kyuditsky/rPi_hat/5013-5v/LM5013-Q1_PSPICE_TRANS/LM5013-Q1_PSPICETransientModel_FeaturesandLimitations.pdf

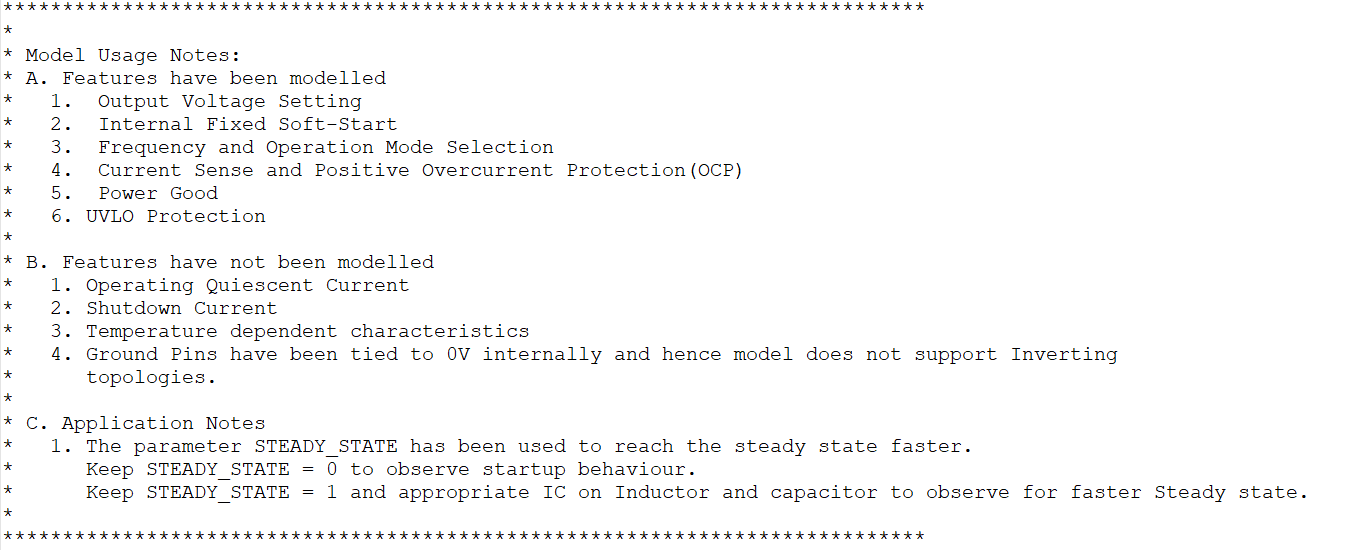
[picture p1: figure]
