kyuditsky/rPi_hat/5013-5v/5013-5v/lm5013_5v.png

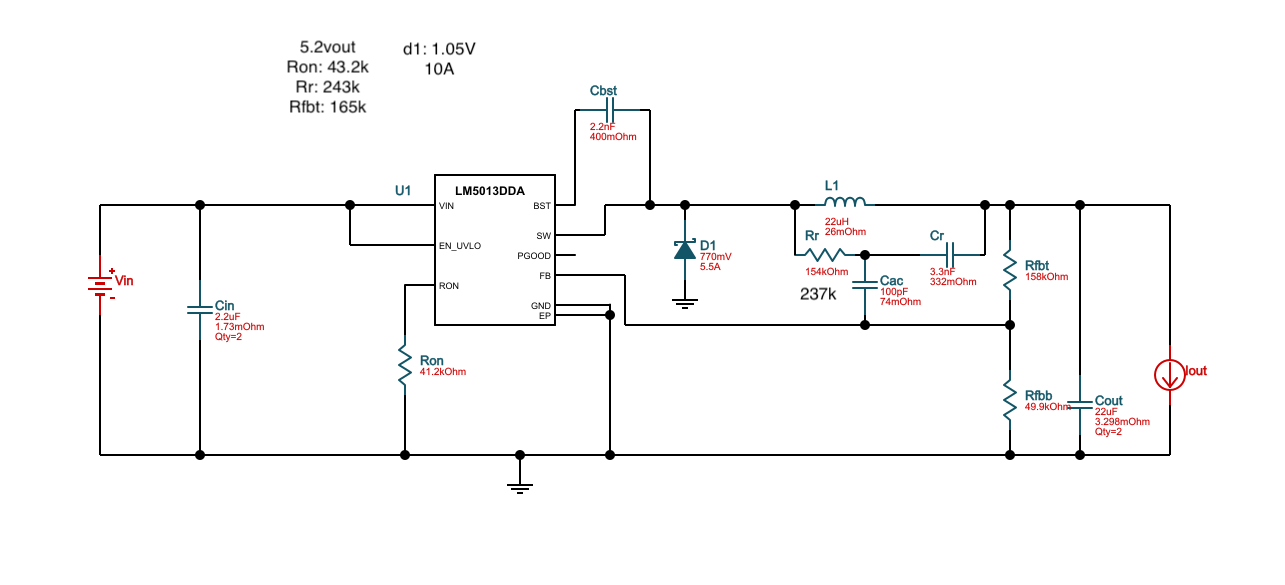
5013-5v/5013-5v/lm5013_5v.png
