kyuditsky/rPi_hat/(list of files, drawings)

Other design files:
5013-5v/LM5013-Q1_PSPICE_TRANS/LM5013-Q1_TRANS.OPJ
5013-5v/LM5013-Q1_PSPICE_TRANS/LM5013-Q1DDA_TRANS.OLB
