kyuditsky/rPi_hat/5013-5v/5013-5v/5013-5v.kicad_pcb

## KiCad design 5013-5v/5013-5v/5013-5v.kicad_pcb (2026-02-10)

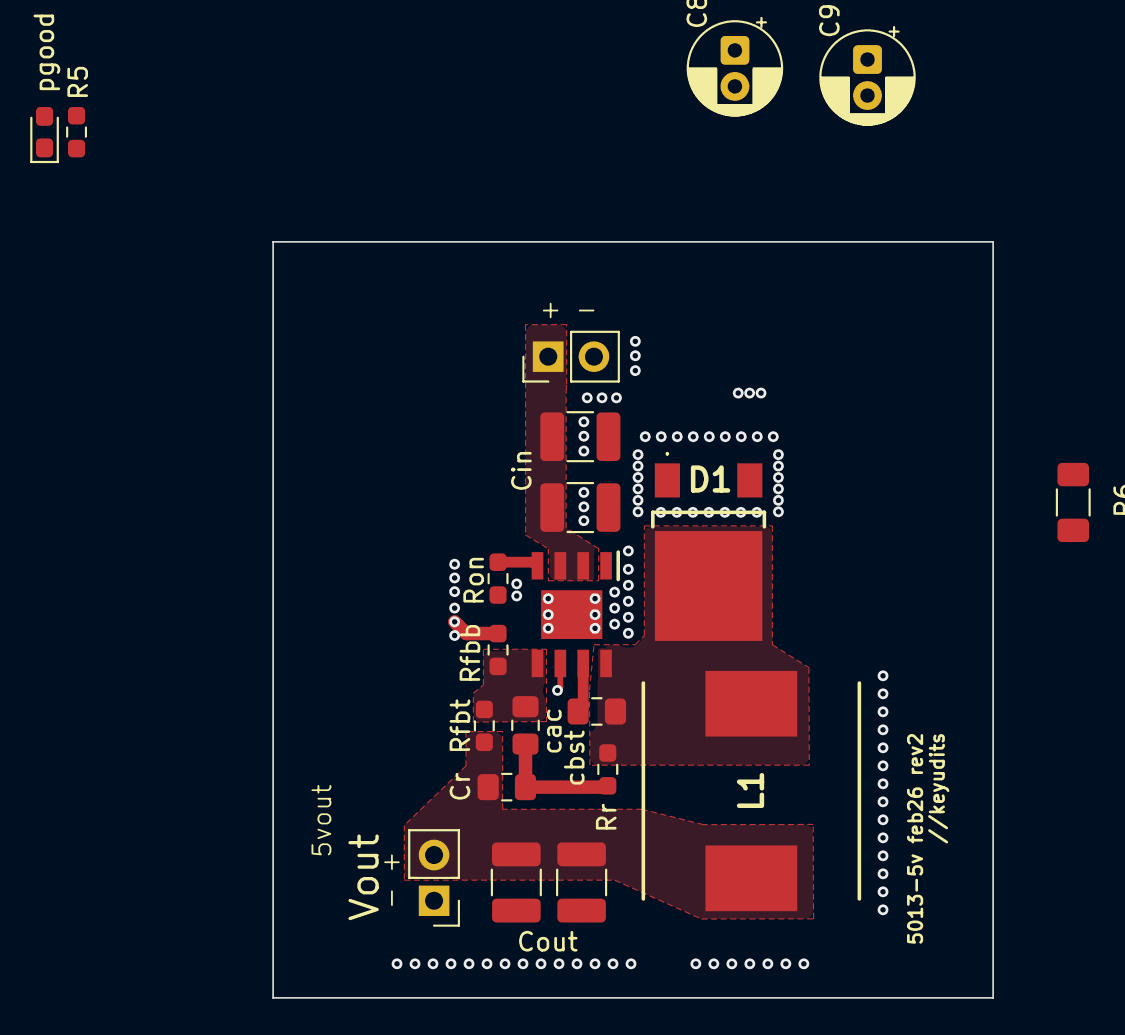
[picture p3: board 5013-5v.kicad_pcb from above]

Board: 2 copper layers, 40.0 x 42.0 mm, 21 parts (0 on the bottom side), 11 nets.

Parts:
C8, C9: C_Polarized; CP_Radial_D5.0mm_P2.00mm
Cin: 2.2u; C_1210_3225Metric_Pad1.33x2.70mm_HandSolder
Cin#2: 2.2uF; C_1210_3225Metric_Pad1.33x2.70mm_HandSolder
Cout: 22uF; C_1210_3225Metric_Pad1.33x2.70mm_HandSolder
Cout#2: 22uF; C_1210_3225Metric_Pad1.33x2.70mm_HandSolder
Cr: 3.3nF; C_0805_2012Metric_Pad1.18x1.45mm_HandSolder
D1: D_Schottky; TO-252-Ae-3
IC1: LM5013DDAR; SOIC127P600X170-9N
L1: 22uH; INDPM120120X1020N
R5: 2.2k; R_0603_1608Metric_Pad0.98x0.95mm_HandSolder
R6: 0; R_1206_3216Metric_Pad1.30x1.75mm_HandSolder
Rfbb: 49.9kOhm; R_0603_1608Metric_Pad0.98x0.95mm_HandSolder
Rfbt: 158kOhm; R_0603_1608Metric_Pad0.98x0.95mm_HandSolder
Ron: 41.2kOhm; R_0603_1608Metric_Pad0.98x0.95mm_HandSolder
Rr: 154kOhm; R_0603_1608Metric_Pad0.98x0.95mm_HandSolder
Vin: Conn_01x02_Pin; PinHeader_1x02_P2.54mm_Vertical
Vout: Conn_01x02_Pin; PinHeader_1x02_P2.54mm_Vertical
cac: 100pF; C_0805_2012Metric_Pad1.18x1.45mm_HandSolder
cbst: 2.2nF 50v X7R; C_0805_2012Metric_Pad1.18x1.45mm_HandSolder
pgood: LED; LED_0603_1608Metric_Pad1.05x0.95mm_HandSolder

Connections:
/Vin: C8.1, C9.1, Cin.1, Cin#2.1, IC1.2 (VIN), IC1.3 (EN/UVLO), Vin.1
/Vout: Cout.1, Cout#2.1, Cr.2, L1.2, Rfbt.1, Vout.2
/fb: IC1.5 (FB), Rfbb.1, Rfbt.2, cac.2
/sw: D1.1 (K), IC1.8 (SW), L1.1, Rr.1, cbst.1
GND: Cout.2, Cout#2.2, R6.1, Rfbb.2, Vout.1, pgood.1 (K)
GND1: C8.2, C9.2, Cin.2, Cin#2.2, D1.2 (A), IC1.1 (GND), IC1.9 (EP), R6.2, Ron.2, Vin.2
unnamed: Cr.1, Rr.2, cac.1
unnamed: IC1.7 (BST), cbst.2
unnamed: IC1.6 (PGOOD), R5.2
unnamed: IC1.4 (RON), Ron.1
unnamed: R5.1, pgood.2 (A)
