kyuditsky/rPi_hat/5013-5v/5013_hat/5013-5V_hat.kicad_pcb

## KiCad design 5013-5v/5013_hat/5013-5V_hat.kicad_pcb (2025-11-10)

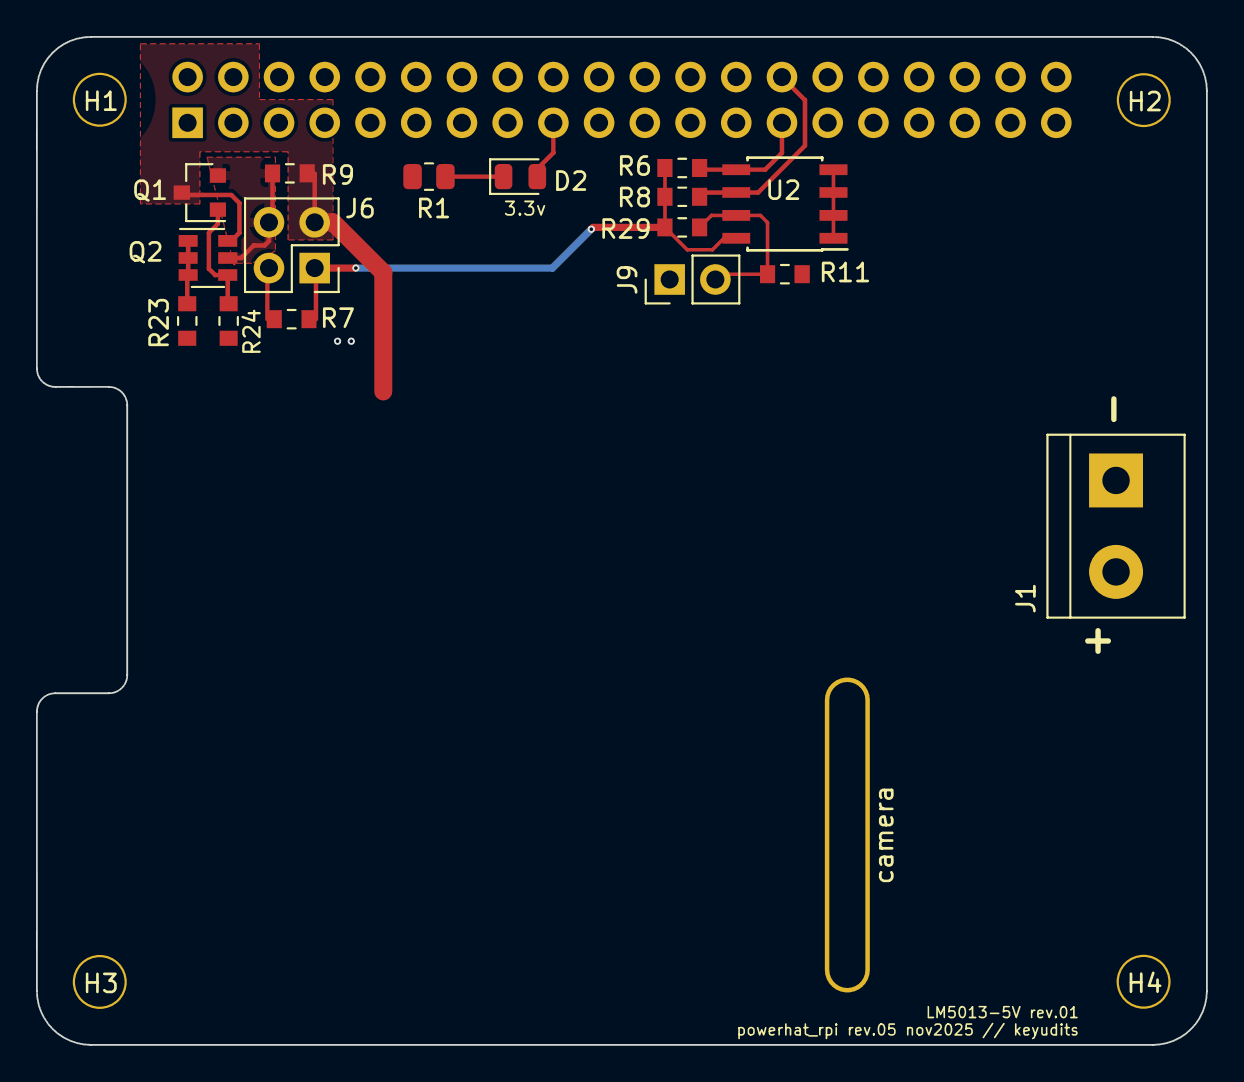
[picture p4: board 5013-5V_hat.kicad_pcb from above]

Board: 2 copper layers, 65.0 x 56.0 mm, 22 parts (1 on the bottom side), 12 nets.

Parts:
D2: LED; LED_0805_2012Metric
H1, H2, H3, H4: 3mm_Mounting_Hole; NPTH_3mm_ID
J1: Input; TerminalBlock_bornier-2_P5.08mm
J3: 40HAT; PinSocket_2x20_P2.54mm_Vertical
J6: CONN_02X02; PinHeader_2x02_P2.54mm_Vertical
J9: CONN_01X02; PinHeader_1x02_P2.54mm_Vertical
Q1: DMG2305UX; SOT-23
Q2: DMMT5401; SOT-23-6
R1: 2.2k; R_0805_2012Metric
R6, R8: 3.9K; R_0603_1608Metric_Pad0.84x1.00mm_HandSolder
R7, R9, R11: DNP; R_0603_1608Metric_Pad0.84x1.00mm_HandSolder
R23, R29: 10K; R_0603_1608Metric_Pad0.84x1.00mm_HandSolder
R24: 47K; R_0603_1608Metric_Pad0.84x1.00mm_HandSolder
U2: CAT24C32; SOIC-8_3.9x4.9mm_P1.27mm
camera: raspberry_pi_camera_cutout

Connections:
/ID_SC_EEPROM: J3.28 (BCM1), R8.2, U2.6 (SCL)
/ID_SD_EEPROM: J3.27 (BCM0), R6.2, U2.5 (SDA)
/LED: D2.2 (A), J3.17 (P3V3)
/P3V3: J6.1, R6.1, R7.2, R8.1, R29.1, U2.8 (VCC)
/P3V3_HAT: J3.1 (P3V3), J6.2, R7.1
/P5V: J6.3, Q1.3 (D), Q2.6 (E), R9.2
/P5V_HAT: J3.2 (P5V), J3.4 (P5V), J6.4, Q1.2 (S), Q2.5 (E), R9.1
GND: J3.6 (GND), J3.9 (GND), J3.14 (GND), J3.20 (GND), J3.25 (GND), J3.30 (GND), J3.34 (GND), J3.39 (GND), J9.1, R1.1, R11.2, R23.2, R24.2, U2.1 (A0), U2.2 (A1), U2.3 (A2), U2.4 (GND)
unnamed: D2.1 (K), R1.2
unnamed: J9.2, R11.1, R29.2, U2.7 (WP)
unnamed: Q1.1 (G), Q2.4 (C), R24.1
unnamed: Q2.1 (C), Q2.2 (B), Q2.3 (B), R23.1
