kyuditsky/rPi_hat/5116-05/LM5116-05.kicad_pcb

## KiCad design 5116-05/LM5116-05.kicad_pcb (2025-11-11)

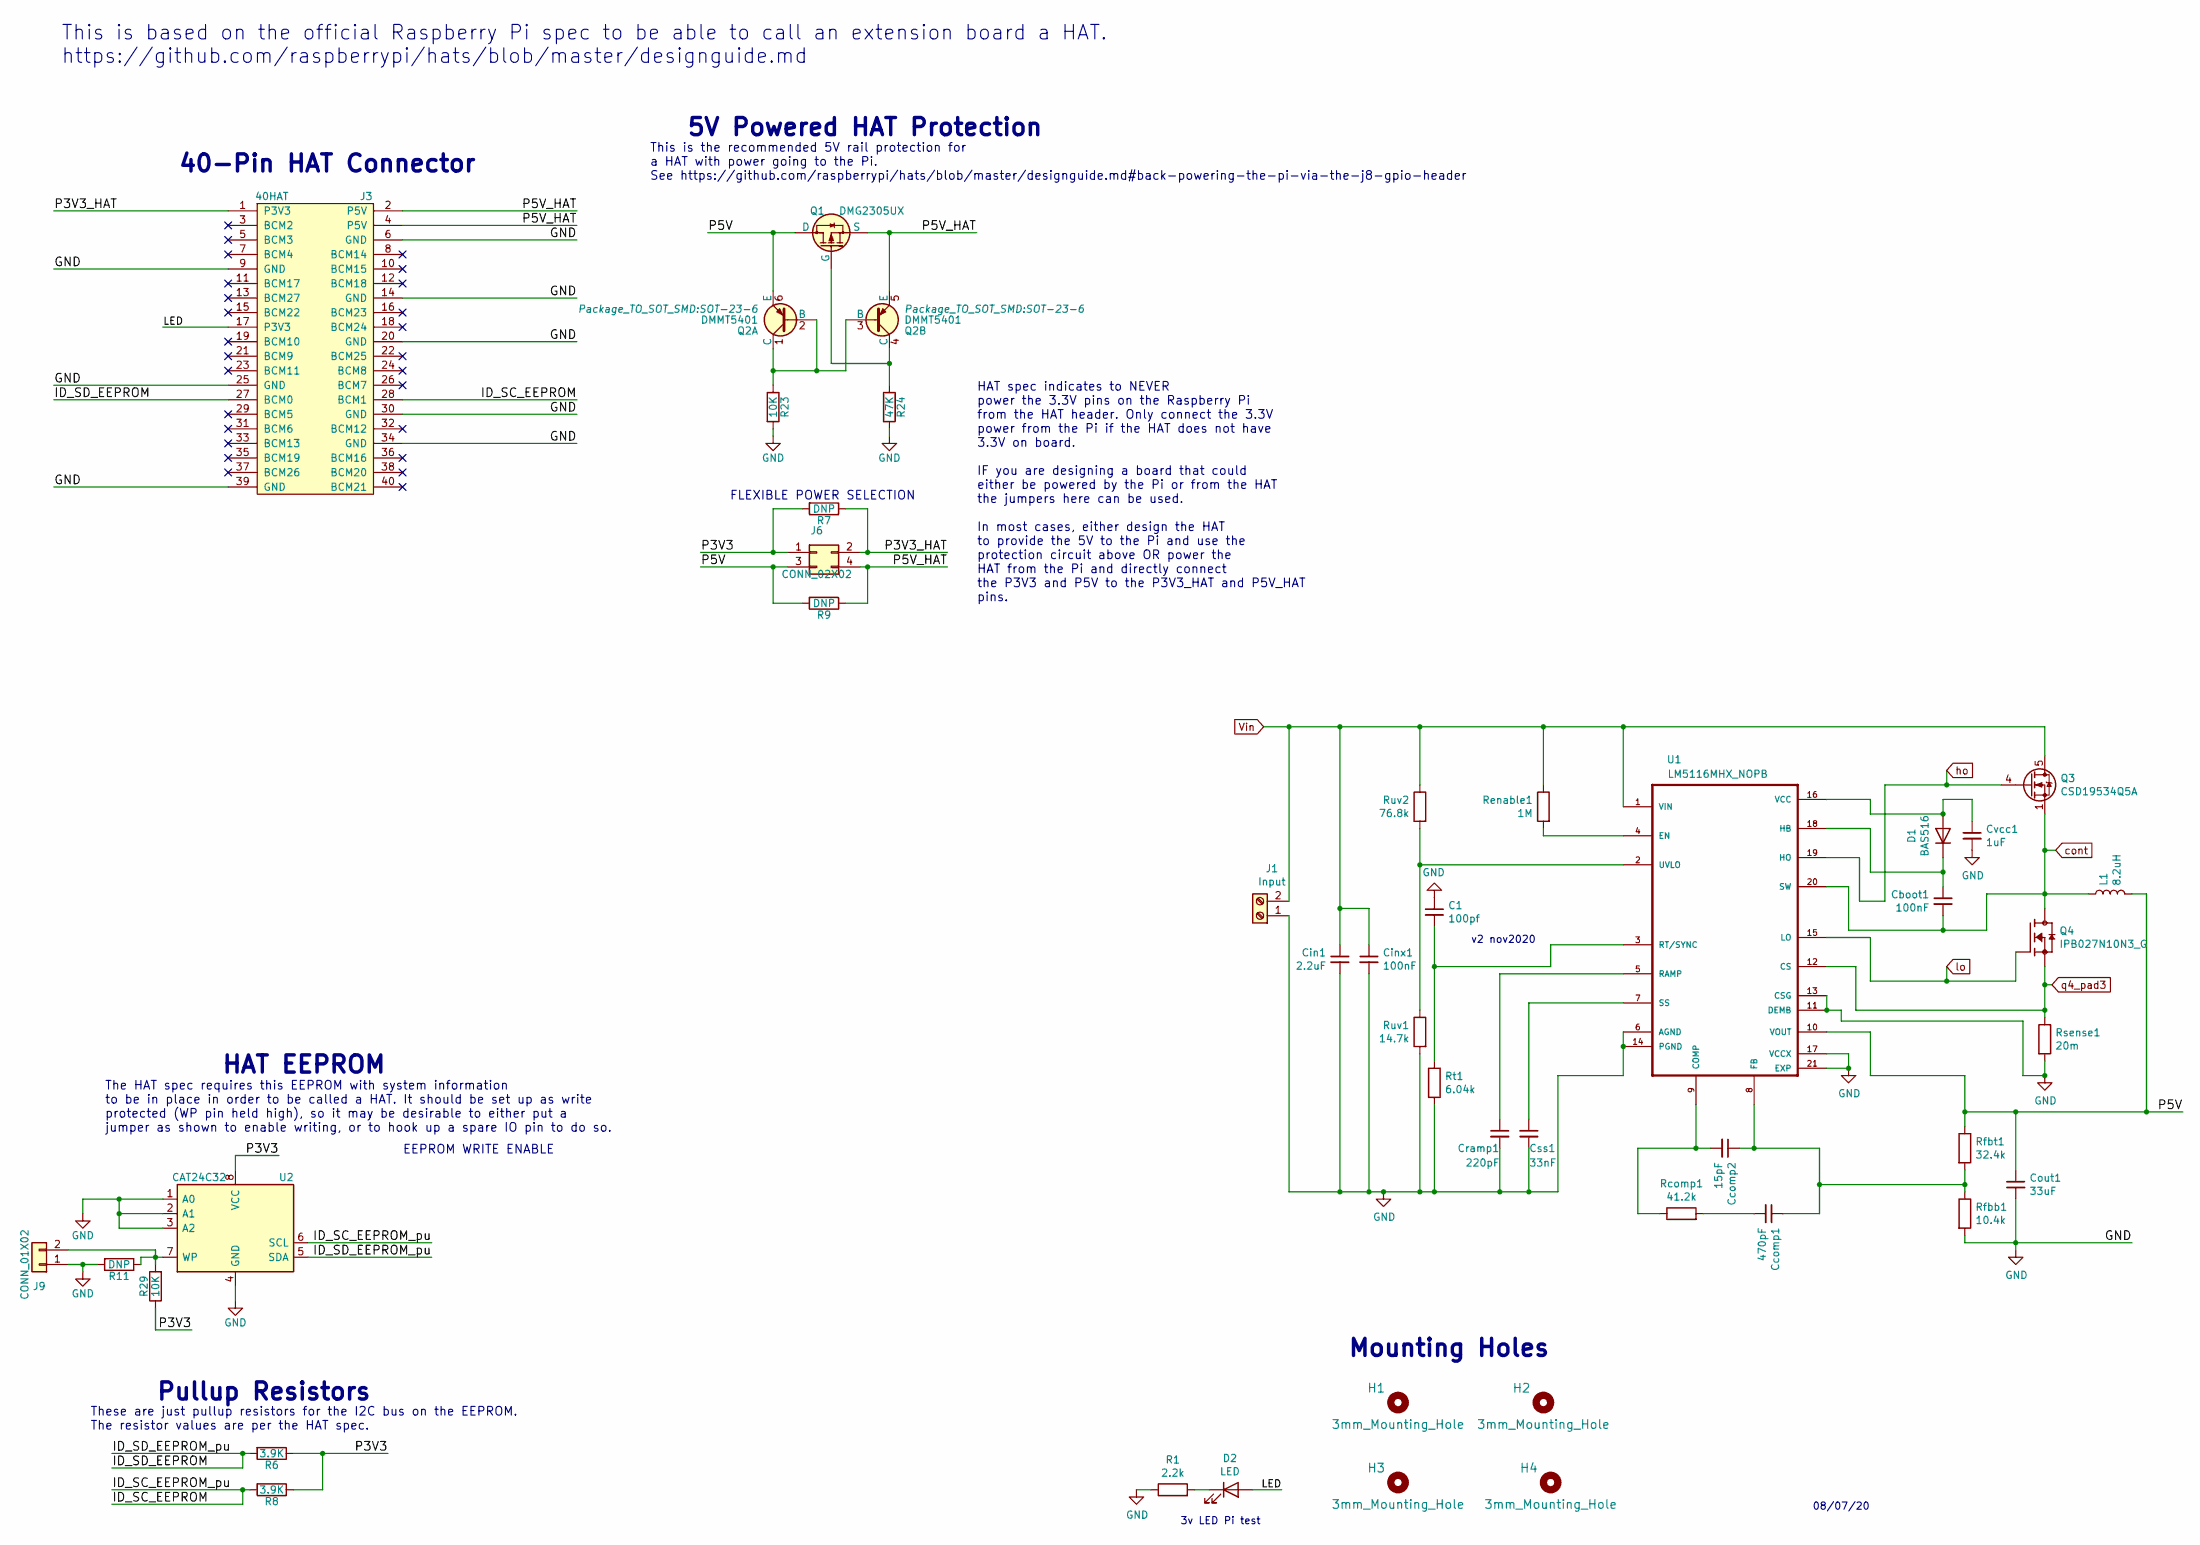
[picture p5: schematic LM5116-05.kicad_sch, Raspberry Pi HAT]

Parts:
C1: 100pf; C_Disc_D3.0mm_W2.0mm_P2.50mm
Cboot1: 100nF; C_0402_1005Metric
Ccomp1: 470pF; C_0402_1005Metric
Ccomp2: 15pF; C_0402_1005Metric
Cin1: 2.2uF; C_1210_3225Metric
Cinx1: 100nF; C_0805_2012Metric
Cout1: 33uF; C_1206_3216Metric
Cramp1: 220pF; C_0402_1005Metric
Css1: 33nF; C_0805_2012Metric
Cvcc1: 1uF; C_0805_2012Metric
D1: BAS516; D_SOD-523
D2: LED; LED_0805_2012Metric
H1, H2, H3, H4: 3mm_Mounting_Hole; NPTH_3mm_ID
J1: Input; TerminalBlock_bornier-2_P5.08mm
J3: 40HAT; PinSocket_2x20_P2.54mm_Vertical
J6: CONN_02X02; PinHeader_2x02_P2.54mm_Vertical
J9: CONN_01X02; PinHeader_1x02_P2.54mm_Vertical
L1: 8.2uH; L_Bourns_SRP6540
Q1: DMG2305UX; SOT-23
Q2: DMMT5401; SOT-23-6
Q3: CSD19534Q5A; TDSON-8-1
Q4: IPB027N10N3_G; TO254P1524X457-4N
R1: 2.2k; R_0805_2012Metric
R6, R8: 3.9K; R_0603_1608Metric_Pad0.84x1.00mm_HandSolder
R7, R9, R11: DNP; R_0603_1608Metric_Pad0.84x1.00mm_HandSolder
R23, R29: 10K; R_0603_1608Metric_Pad0.84x1.00mm_HandSolder
R24: 47K; R_0603_1608Metric_Pad0.84x1.00mm_HandSolder
Rcomp1: 41.2k; R_0402_1005Metric
Renable1: 1M; R_0402_1005Metric
Rfbb1: 10.4k; R_0805_2012Metric
Rfbt1: 32.4k; R_0402_1005Metric
Rsense1: 20m; R_1206_3216Metric
Rt1: 6.04k; R_0402_1005Metric
Ruv1: 14.7k; R_0805_2012Metric
Ruv2: 76.8k; R_0805_2012Metric
U1: LM5116MHX_NOPB; SOP65P640X120-21N; Manufacturer_Part_Number LM5116MH/NOPB; Mouser Part Number 926-LM5116MH/NOPB
U2: CAT24C32; SOIC-8_3.9x4.9mm_P1.27mm

Connections:
/ID_SC_EEPROM: J3.28 (BCM1), R8.2, U2.6 (SCL)
/ID_SD_EEPROM: J3.27 (BCM0), R6.2, U2.5 (SDA)
/LED: D2.2 (A), J3.17 (P3V3)
/P3V3: J6.1, R6.1, R7.2, R8.1, R29.1, U2.8 (VCC)
/P3V3_HAT: J3.1 (P3V3), J6.2, R7.1
/P5V: Cout1.1, J6.3, L1.2, Q1.3 (D), Q2.6 (E), R9.2, Rfbt1.1, U1.10 (VOUT); also elsewhere on the board
/P5V_HAT: J3.2 (P5V), J3.4 (P5V), J6.4, Q1.2 (S), Q2.5 (E), R9.1
GND: C1.1, Cin1.2, Cinx1.2, Cout1.2, Cramp1.2, Css1.2, Cvcc1.2, J1.1, J3.6 (GND), J3.9 (GND), J3.14 (GND), J3.20 (GND), J3.25 (GND), J3.30 (GND), J3.34 (GND), J3.39 (GND), J9.1, R1.1, R11.2, R23.2, R24.2, Rfbb1.2, Rsense1.2, Rt1.2, Ruv1.2, U1.6 (AGND), U1.11 (DEMB), U1.13 (CSG), U1.14 (PGND), U1.17 (VCCX), U1.21 (EXP), U2.1 (A0), U2.2 (A1), U2.3 (A2), U2.4 (GND); also elsewhere on the board
unnamed 8: C1.2, Rt1.1, U1.3 (RT/SYNC); also elsewhere on the board
unnamed: Cboot1.1, D1.1 (K), U1.18 (HB)
unnamed: Ccomp1.1, Ccomp2.1, Rfbb1.1, Rfbt1.2, U1.8 (FB)
unnamed: Ccomp1.2, Rcomp1.2
unnamed: Ccomp2.2, Rcomp1.1, U1.9 (COMP)
unnamed: Cramp1.1, U1.5 (RAMP)
unnamed: Css1.1, U1.7 (SS)
unnamed: Cvcc1.1, D1.2 (A), U1.16 (VCC)
unnamed: D2.1 (K), R1.2
unnamed: J9.2, R11.1, R29.2, U2.7 (WP)
unnamed: Q1.1 (G), Q2.4 (C), R24.1
unnamed: Q2.1 (C), Q2.2 (B), Q2.3 (B), R23.1
unnamed 20: Renable1.2, U1.4 (EN); also elsewhere on the board
unnamed: Ruv1.1, Ruv2.2, U1.2 (UVLO)
Vin: Cin1.1, Cinx1.1, J1.2, Q3.5 (D), Renable1.1, Ruv2.1, U1.1 (VIN)
cont: Cboot1.2, L1.1, Q3.1 (S), Q3.2 (S), Q3.3 (S), Q4.2, U1.20 (SW); also elsewhere on the board
ho: Q3.4 (G), U1.19 (HO)
lo: Q4.1, U1.15 (LO)
q4_pad3: Q4.3, Rsense1.1, U1.12 (CS)

Notes on the sheet:
3v LED Pi test
This is the recommended 5V rail protection for a HAT with power going to the Pi. See https://github.com/raspberrypi/hats/blob/master/designguide.md#back-powering-the-pi-via-the-j8-gpio-header
5V Powered HAT Protection
08/07/20
HAT EEPROM
Pullup Resistors
The HAT spec requires this EEPROM with system information to be in place in order to be called a HAT. It should be set up as write protected (WP pin held high), so it may be desirable to either put a jumper as shown to enable writing, or to hook up a spare IO pin to do so.
This is based on the official Raspberry Pi spec to be able to call an extension board a HAT. https://github.com/raspberrypi/hats/blob/master/designguide.md
HAT spec indicates to NEVER power the 3.3V pins on the Raspberry Pi from the HAT header. Only connect the 3.3V power from the Pi if the HAT does not have 3.3V on board. IF you are designing a board that could either be powered by the Pi or from the HAT the jumpers here can be used. In most cases, e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
EEPROM WRITE ENABLE
These are just pullup resistors for the I2C bus on the EEPROM. The resistor values are per the HAT spec.
v2 nov2020
40-Pin HAT Connector
Mounting Holes
FLEXIBLE POWER SELECTION

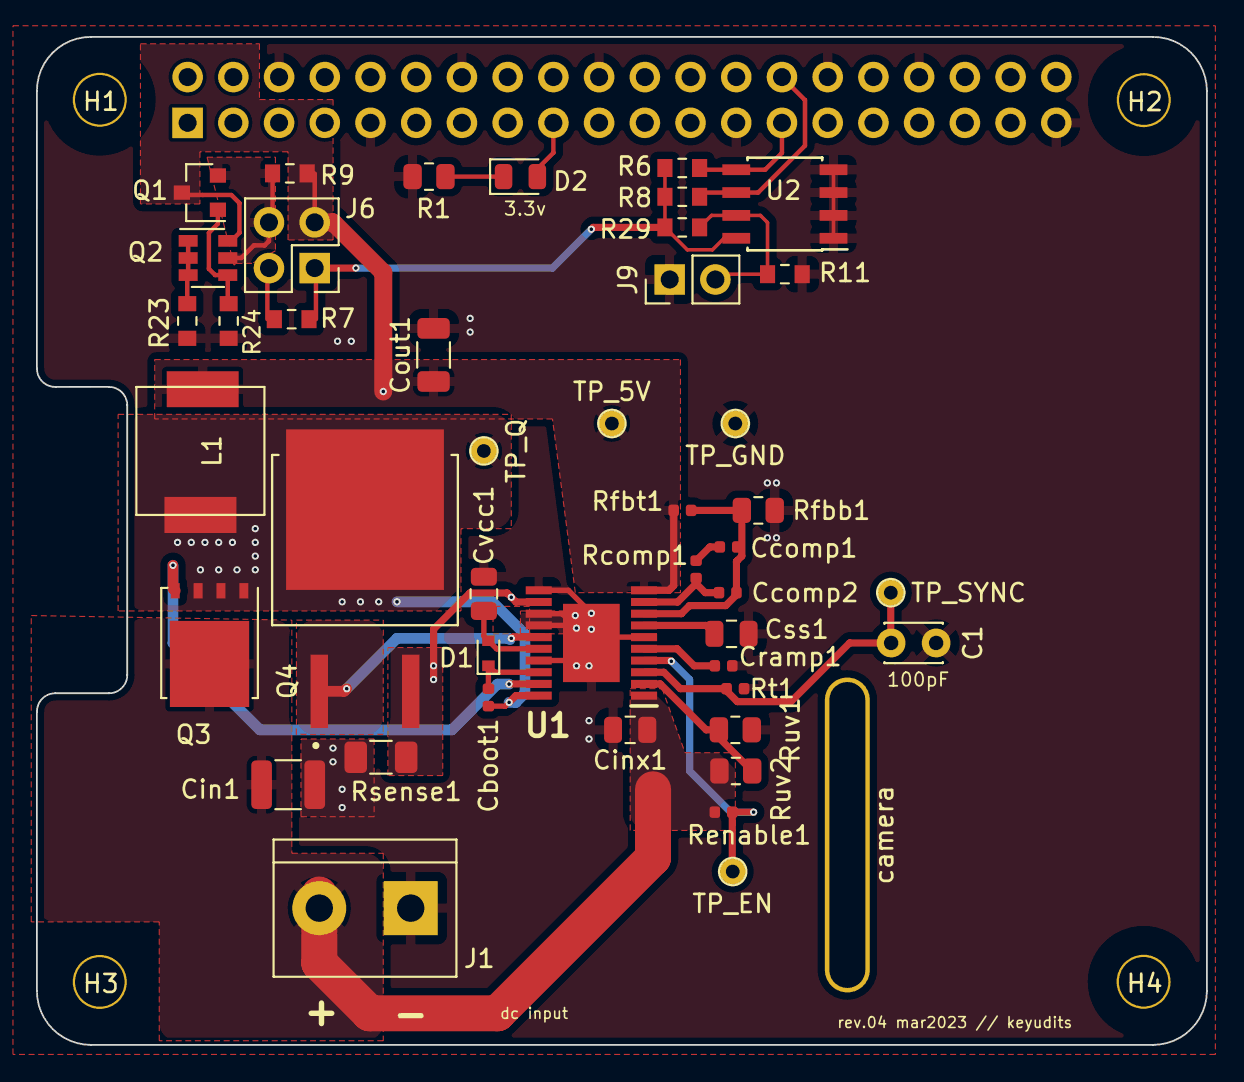
[picture p6: board LM5116-05.kicad_pcb from above]

Board: 2 copper layers, 65.0 x 56.0 mm, 50 parts (1 on the bottom side), 27 nets.

Other parts of the board:
TP_5V: test_point
TP_EN: test_point
TP_GND: test_point
TP_Q: test_point
TP_SYNC: test_point
camera: raspberry_pi_camera_cutout

Their connections:
/P5V: TP_5V.1; also elsewhere on the board
GND: TP_GND.1; also elsewhere on the board
unnamed 8: TP_SYNC.1; also elsewhere on the board
unnamed 20: TP_EN.1; also elsewhere on the board
cont: TP_Q.1; also elsewhere on the board
