kyuditsky/rPi_hat/buildnotes_rpi_hat.txt

may1_23

rev.04

Steady 5vDC output

9-50vDC input (no load)

8-46vDC input (drawing 0.5 - 1.4 Watt load)

***
11/10/25

	test most current board, with a rpi load
	look at new topologies
	reorganize git	
		5116_05 > bury in new folder
		git folder is rpi_hat
		new folder: 5013-5v

new topology: LM5013 - 6-100vin (48v nominal) 3.5A out
	schematic captured, assigning footprints

	called out schottkey diode not available
		new selection: V20PW22HM3_A/I
		added to webench design, and it broke.

***
testing powerhat_rev4.0

test case:
	riden power supply, sweeping DCv, Iout=300mA
	waveforms scope1+ to hat_TP_5v
	observing using waveforms voltmeter
	all equipment gnds connected
	
	Load: 1 small LED + 1kohm R series, tp_5v>gnd

<DC8v: voltage drops to ~1.4v
>DC8.1v: 5.07v, 50mA

sweeping V, in 1v steps:
	as Vin increases, I decreases (expected)
stability drops off at DC46V = 5.06V 32mA

Vout off, adjusted to 50v, vout on
	stable for a few seconds, then drops off
	~1.4V output
tried the same at 48V 52V and 54V
	same result, tho the lower the V the longer it takes to fall apart

Conclusion: (not quite true)
Rev4 operable with small (<50mA) load
	DC8.1V to 46V 

further testing:
	only sat at each voltage for a few seconds; 
	stress testing at 46V
		by 7minutes, Vout dropped to 3v

	testing again with observation:
		46V held 30mA load @ 5V for 5 minutes
	
	testing at
		24V held 42mA @ 5V at least 12 minutes
			(expecting at least twice as much time)

switching voltmeter to scope 1

ripple present:

8.1v	100mV	>1MHz
9v	139mV	>500kHz
12v	123mV	>500kHz
24v	115mV	200kHz
46v	165mV	150kHz
	 
50v	44mV	600kHz	Vout drops to 1.4V
	fairly abrupt drop, swinging oscillations observed briefly
		then stable
55V	vout drops to 1V

____
pulling LED, adding rpi3 load
		no peripherials

setting riden supply direct to rpi gpio power
	5V 1A
	rpi load spikes to 550mA

attaching powerhat
	
12vin
	vout falls to 3.5v
24vin
	vout falls to 4.8v
36vin
	vout falls to 4v
46vin
	vout falls to 2.7v

scope
24vin 1A	sawtooth wave, 1v peak2peak
		avg 3.5v	
24vin 2A	square with sawtooth lows
		2.5v p2p
		avg 4.2v
		
24vin 3A	avg 4.7v, max 5.2v
		2v p2p
		providing more current gets us closer
			tho riden displays 50mA

	****		
	signal not clean enough to truely power rpi
	*****

****
5013 datasheet layout guidelines:

To help eliminate these problems, bypass the VIN pin to GND with a low-ESR ceramic bypass capacitor with
a high-quality dielectric. Place CIN as close as possible to the VIN and GND pins. Grounding for both the
input and output capacitors must consist of localized top-side planes that connect to the GND pin and GND
PAD.
• Minimize the loop area formed by the input capacitor connections to the VIN and GND pins.
• Place the inductor and Schottky diode close to the SW pin. Minimize the area of the SW trace or plane to
prevent excessive capacitive coupling.
• Place the Schottky diode anode pin in close proximity to input capacitor ground or return.
• Tie the GND pin directly to the power pad under the device and to a heat-sinking PCB ground plane.
• Use a ground plane in one of the middle layers as a noise shielding and heat dissipation path.
• Have a single-point ground connection to the plane. Route the ground connections for the feedback, soft
start, and enable components to the ground plane, which prevents any switched or load currents from flowing
in analog ground traces. If not properly handled, poor grounding results in degraded load regulation or erratic
output voltage ripple behavior.
• Make VIN, VOUT, and ground bus connections as wide as possible, which reduces any voltage drops on the
input or output paths of the converter and maximizes efficiency.
Minimize trace length to the FB pin. Place both feedback resistors, RFB1 and RFB2, close to the FB pin. Place
CFF (if needed) directly in parallel with RFB1. If output setpoint accuracy at the load is important, connect the
VOUT sense at the load. Route the VOUT sense path away from noisy nodes and preferably through a layer on
the other side of a grounded shielding layer.
• The RON pin is sensitive to noise. Thus, locate the RRON resistor as close as possible to the device and route
with minimal lengths of trace. The parasitic capacitance from RON to GND must not exceed 20 pF.
• Provide adequate heat sinking for the LM5013 to keep the junction temperature below 150°C. For operation
at full rated load, the top-side ground plane is an important heat-dissipating area. Use an array of heatsinking vias to connect the exposed pad to the PCB ground plane. If the PCB has multiple copper layers,
these thermal vias must also be connected to inner layer heat-spreading ground planes.

****
11/18/25

check bananajack module pcb carrier
	fit prototype into carrier if possible		#looks good

:40x72mm with 2mm safezone offset

*****
'Selecting an Ideal Ripple Generation Network for Constant-On-Time Buck Converter'
https://www.ti.com/lit/an/snva776a/snva776a.pdf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

from:
Type 3 Ripple Network:
	
	--feedback resistors create a divider that adjusts the output voltage--

added rev1 BOMs
	-kicad: 	kicad generated
	-part#.numbers	mac numbers worksheet
	-part#.csv	mouser upload format

rev1 BOM cost-mouser: 16.13 + 2.71 tariff

11/24/25
ordered multiple passive
	3 items each -d1, ic1, l1
ordered pcbs
fedex

****
12/02/25
parts arrived, pcb's arrived

populated pcb
dnp: cin2, cout2, c8,c9, r5, pgoodLED

waveforms test
riden 	psu + to Vin+
	psu - to Vin-
AD2 - 	scope1+ to Vout+
	scope1- to AD2gnd, Vout-

Voltmeter
no load besides AD2
riden set to 3Aout
	PSU DC	Vout	AC RMS (assume ripple)
	12	5.019	19mV
	7v	5.032	20mV
	6v	collapse
	24v	5.036	26mV
	36v	5.041	28mV
	48v	5.046	30mV
	56v	5.048	32mV
	59v	5.048	33mV	(maxxed out riden)

Scope
ripple frequency decreases as Vin increases

adding in breadboard
	powerhat to rails, scope on rails
	led+1kR, DHT22 load
patching rpi3, 5v gnd headers to rails
	voltmeter stabilized at ~4vDC
	initially encountered an undervoltage error
	reset power to reboot, succesfully booted raspian
	rolled through riden vout:
	48v, 32v, 28v, 20v, 12v, 7vdc
		rpi stayed booted no issues
	ripple/noise decreased as Vin decreased
	
tested a drop from 48v to 7v and rpi crashed & rebooted
	tested 48v to 12vdc, no problem
*try the same test with all the capacitors*

back to build
	led-	0603 footprint, 0805 package 5 onhand from 36628532 (mfg#APT2012LZGCK)
	r5- 	2.2k
added cin2, cout2, headers for vin vout

THTelectrocaps on hand were only rated for 50vDC, so ommitted

powering on, basic LED load
	pgood led is not lit
	pgood net at IC is 2mV
		was sort of unsure about this implementation anyway

switching to rpi load
	12vdc in	drawing 90-160mA, but not stable for pi
		keeps rebooting
	switching to 24vin, 48v, no change, not stable
removing rpi load
	stable 5vout, 7vin, 48vin
pulled r5 (led resistor), testing again

powering pi direct from riden, 5vout
	pi draws ~500mA
back to powerhat, took a while but booted at 18vDC in
drawing 125mA
scope is stable at 4.25vDC, powerhat is audibly noisy

attempted 48vin to 7vin, crashed the pi again
	pi did reboot at 7vin
pgood cicuit may have destablized the powerhat, also shutdown pi with software
	(while powered by the riden)
	which may have been the culprit
powerhat can jump from 7vin to 48vin while providing stable 5vout powering a pi
	thats cool.
	riden is supplying 40mA while powering pi
	[note the hdmi was backfeeding some power]

****
12/9/25

building out a 2nd board

pcb was designed 40x72mm 
pcb carriers on hand are 40x42mm (bananajack breakout)

***
ACS711
[NOTE: datasheet states <100v isolation applications]

current sense first tests:

riden psu to powerhat (24v)

vout+ to afe Ip/In to breadboard +
vout- 		to breadboard -
breadboard-	to afe earth & dgnd
		to ad2 gnd

breadboard has an LCD1602 & 1led installed

AD2 power supply 3.3v to AFE

AFE A2 to AD2 scope1+, 	A2 voltmeter: 1.66V

riden turned off	A2 voltmeter: 1.66v
	no change
	[3.3v /2 = 1.66v]		#read online that Vcc/2 is baseline, double check datasheet
	
[see diagram]
	*draw diagram

adding rPi to breadboard rails:
	(no hdmi out)

A2 voltmeter:	1.674-1.681v
(im not positive that the pi boots without the HDMI
	need to check with the TTL console cable)
riden is showing 44mA out

rpi does not appear to boot
	gets to a point then resets
	vout flucuates
added 22uf and 1uf electro caps to rails

okay
resetting riden to 5v and directly to breadboard rails
pi booted fine

AD2 reading 4.7V on positive rail
riden reading 500mA out

back to the powerhat, riden at 24v
pulled ACS711 out of the loop
will pi boot? 

unrelated - rightangle safety bananajacks can be had in semi-bulk from ebay
	for way less than mouser/individual
	knockoffs but says 1000v/24a

12/10/25
built 2nd pcb
	-DNP pgood1, r5, cout2, c8,c9

testing board2

noload
ridenVin	powerhatVout
	12	5.074
	24	5.087
	32	5.091
	48	5.096
	7	5.079
	6	null
	59	5.1

breadboard rails - LED + lCD1602
	similar results

adding pi load + hmdi
	riden pulling 95mA
	voltmeter on rails - 4.386
pi boots just fine
	note hdmi is backfeeding breadboard/pi
switching to powerhat1
	functional difference is Cout2 is populated
	pi boots just fine today
	weird
	rail is at 4.395, LCD flickers/dim
consider adding lm7805 regulator
	*7805 needs at least 7.3v input
	*doesnt fit the use case
	*could redesign powerhat to output 7.5v, to regulate to 5v
	*would only provides 1.5A output (7805 limitation)

the lcd + led on breadboard draw 14mA @ 5vin

cut down powerhat rev1 board 2 to fit into 40x42mm din rail carrier
	still works

****
12/15/25

installed puTTY on win10 q400a machine
connected usb-to-serial cable

powered pi via 2.4a microUSB cable
	confirmed serial connection

powered pi via powerhat
	was not able to boot/connect via serial

***
double checking lm5013 datasheet
	should be able to pull 3.5A max
seems like a current issue, when trying to boot, powerhat pulls up to 150mA from riden
with some regularity, drops to ~40mA, before rising back up
scope shows 5V DC with drops as low as 3.4V dc
coincides with current dropout

Pgood is open-drain output, Pull-up, needs connected to source V via 10k-100k R
	(i had it setup as a pulldown connected to GND)
	neither board has the pgood1 R or LED populated

going to try a 10k R from pgood to vout+ on board1
testing board 1 first (Same setup as earlier)

no change to rpi boot

added old pi-hat project, with the transistors and mosfets at 5v_Hat
no joy

back to riden direct, through the old pi-hat
pulling upwards of 700mA

using the riden/hat doesnt give a stable boot either (it was a trash hat anyway)
directly from the riden to pi doesnt give stable boot, suspect pi needs a true software reboot

reboot helped
was able to do a puTTY boot from riden

powerhat would not boot the rpi without an hdmi cable attached

suspect powerhat isnt providing enough current during startup
	& the stable 50mA backfed from the hdmi is enough to boot it

***
12/16/25

considered redesigning the 5013 to output 7.5v and using a 7805 for max 1.5A
	but realized just doing that wouldnt increase the current output of the 5013 as is

added a variety of electro caps on the input as well as output
	while it smoothed the waveform it did not provide enough current smoothing to boot
pi trying to boot:
input freq ~ 150kHz
output freq ~ 300kHz

simple load:
in 300-400kHz
out 7kHz

added 8.2uH inductor in series to V+ from supply to vin+
____

***
12/30/25

got rid of input inductors and capacitors

testing new load:
	10ohm Resistors
	2 parallel sets in series
	giving 10ohm load, expect 1/2W power rating

24Vin
riden load = 75mA		75mA @ 5V = 3.75W
Voltage on scope = 3.87v
	Vdrop = 1.13v
expected vdrop=0.81v

voltage drop varies based upon Vin
	lower Vin, more drop
48vin - 4.33v	47mA
12vin - 3.45v	110mA
same load

very chaotic signal at 36vin - 4.8v measured 77mA
	audible noise from powerhat

7vin	293mA	4.489Vout

_____

pulled powerhat from circuit

riden - 5Vout
	11ohm load

Vset-	5V
Iset - 	400mA
Vout-	4.26V
Iout-	398mA	

Iset-	500mA
Vout-	4.99V
Iout-	464mA

*********
our 4-resistor 11ohm network draws 464mA
ohms law gives:
	5V, 10.8ohm, 0.462A, 2.31W 
	confirmed with observations
*********
thats the standard
resisters didnt blow up, but giving off a lot of heat

adding back in the powerhat

riden 9vin
scope voltmeter - 3.85v
riden Iout - 180mA

rolling through Vin, 
30Vin gets close at 4.9vout
	Iout 90mA

okay big takeaway: [resistor network is 10.8ohm and draws 464mA]

****
Switching gears to the AFE Current Sense

we know that the Rnetwork pulls 464mA

setup AFE current sense (ACS711)
	powered from AD2 (3.3v)
voltmeter1 > A2 (acs711 output)
voltmeter2 > 3v3 (for accurate reference)

Rnetwork powered by Riden 5Vout
Ip/In in series from +5v to Rnetwork

Vmeter1 shows 1.689v

found formula on web:	[https://www.pololu.com/product/2452]
I = (Vout/Vcc * 36.7) - 18.3

gives	714mA
	669mA

testing with powerhat with rnetwork @ 36Vin
	661mA
	666mA

testing riden with 1k load, riden Vset=5V Iset=1A
	1.0012A

testing powerhat with 1kload, riden Vset=26v Iset=1A
	2.047A

added pi load
	current sense read 0.838 at times but still did not boot

formula seems to work
	did not sucessfully set the voltmeter to scale

***
01/19/26

10W resistors

measured and matched set of 5.1R
setup parallel

riden24V2A

1R 	0.091A
	3.54V
ran into issues with breadboard

wired 3 resistors in parallel on perf board
	measured 2.0 	(1.7 expected)

using the pihat & afe current sense
formula: (Vout/Vcc*36.7)-18.3
current sense returned 820mA

removed afe:
measured current with multimeter: 1.23A

looks like the formula is off

removed pihat
riden5V3A
same 2.0R load
measured current with multimeter: 1.75A
	riden reads: 1.75A
ohms law gives: 2.85R

added scope1 to rail+: 4.00V (1V drop)

added pihat
riden12v3A
riden reads:0.33A
scope1 : 2.59v
Meter reads: 1.0A
ohms law gives 2.85V

doubled the load, 6 resistor in parallel: 1.2R

riden5v2a: pulling 2A

riden5v3a: pulling 2.3A
	scope: 3.69V (1.31v drop)

LOAD: 2.3A
add pihat
riden12v3a		494mA
		meter:	1.43A
		scope:	2.72V

riden24V3a		299ma
			1.68A
			2.93V

riden36v3a		236ma
			1.80A
			2.95v

riden48v3a		183ma
			1.91A
			3.01V

conclusion: using a load that pulls 2.3A
	the pihat was only able to deliver 1.91A

jumping back to 3resistor load: 2ohm
riden24v3a		234mA
			1.14a
			3.244V

added in rpi, did not boot
double checked rpi will boot through serial cable with 5v 2.4a power brick

still seems like a lack of current issue

****
01/20/26

todays plans

attempt headless pi boot from gpio using the riden at 5V3A

look over pi rails schematic

breakout microusb cable and attempt a headless boot from riden
	as well as powerhat, to microusb

look over powerhat schematic, determine efficiancy as vcc increases/decreases
	compare to current pull of load pcb

research inductor saturation and see if we can measure

*
riden5v3a to gpio, 5v through multimeter ammeter
ttl serial cable to usb, blk to gnd, white to tx, grn to rx

max current obs(meter): 740ma
dropout to 120ma, rises back to 740ma max then drops again
riden output matches
no boot

conclude: issue with headless booting through gpio

*
pi rails scheme
usb-b only using vbus+ & gnd
main difference from vbus+ and gpio5v is an smd fuse and proximity to filter caps
draw should never really exceed 800ma

*
confirmed good microUsb (with putty boot), broke out cables (red and blk, 5v & gnd)
powered via riden 5V3A, with ammeter between vcc+ & Vbus+

encountered issues booting through the usb cable after breakout
	suspect ammeter was drawing current away
	after removing ammeter, boots fine
	observing voltage via AD2 scope1
usbbrick voltage 5.18 (no load)
	on powering pi, dropped to no lower than 4.8v

replacing usb brick with riden 5v3a
	dropped to 4.3v
setting riden at 5.2v
	drop as low as 4.1v
	upwards of 700ma
still not booting the pi tho

very odd

test points on pi are PP2 (5v) PP3 (gnd)
	underside of board, next to usbmicroB

riden supply drops to min 4.4v while trying to boot

*
boosted riden to 12v
added 7805 configured to 5vout to breadboard rails
rail is maintaining 4.9-5.0v
adding filter caps doesnt seem to help

still cant get a putty boot

*
okeeedokey
suspect the breadboard/jumper wires might not be too thin to to supply current

connected riden5.2v3a directly to microusb breakout cable
current max on startup: 920ma peak
current typ on running: 395ma
we got a boot!

touch ridenpoweron
sudo shutdown now

conclude: breadboard jumpers are too wimpy to accurately power& test D:

swapping microusb for jumpers direct to gpio
current max on startup: 970ma
pibooted!

touch ridenbootgpio
sudo shutdown now

okay
same cables but jumping through the breadboard
current max: 742ma
no boot

conclude: breadboard is an issue.

*
added headers to a kludge area on old pcb
max current observed: 740ma
pibooted
touch ridenbootthroughjumppcb
sudo shutdown now

powering 1 more time
currentpeaked at 680ma
putty acting strange
did finally boot
current typ on running: 405ma

different jumper setup on jumppcb
peak: 680ma
typ: 404ma
did boot
experienced a brownout
recovered to console
sudo shutdown now

*
adding powerhat in series, passing through jumppcb
riden 18v3a
peak: 80mA

no boot

removing jumppcb
no boot

riden48v3a
	earlier tests proved that the higher VCC, the high the available outputcurrent
still no boot

last ditch, powerhat to microusb
peak: 85mA
no dice

**
hooked ammeter up to powerhat vout to 5vgpio
scope up to 5vgpio
max current: 250mA
voltage swings from 4.9v to 3.5v

conclude: breadboard was definitely causing issues
powerhat can still not supply enough current to power a headless pi

the only difference between microusb+ and 5v gpio is a fuse on microusb

add option for screw or snap terminals on next board
	include 2.54mm spaced headers as well
always include header test points on prototypes

****
02/10/26

shipped 5013-v1, board2, in 40x42mm din rail carrier

testing board1, no breadboard, 2ohm load (of three 5.1ohm load resistors)

9vin, 2a: board began to oscillate, dropping to 1.4a out of riden
	physical pressure applied to 5013 IC, 
		audible oscilation ceased, current increased to 1.6a
	5013 was hot
		leading to believe there is not good ground pad contact under IC

0.3v drop between vout and load, on each side (Vdrop over leads)
3.9v measured between sides of load

**
adding 47uf cap to input side
added series inductor & 47uf cap to output side (through breadboard)

still experienced drops outs as low as 4.3V on trying to boot

*
measuring known good usb power supply, input peaks at 5.1v and drops no lower than 4.89v
boots fine

*
demonstrated with load resistors, 5013v1 can supply at least 1.5a to a constant load, as is

suspect the transient load of the rpi boot throws it off, 
	pi gets stuck in an undervoltage reboot loop
	5013 chip should be able to handle that

**
thoughts on PCBdesign:

the ground planes on the board could be adjusted
	gnd & gnd1 are in/out planes, connected via R6 (jumper)
		
pgood wasnt setup correctly
		rev1 has it pulldown to gnd
	it is an open drain output from the IC
		kludged 10kohm resistor from pgood to vout+
		try a much smaller resistor
			ifnot:
				omit it from rev2 entirely

adjust the circuit frequency to output 5.2v
