kyuditsky/rPi_hat/(commit log)

2023-02-01 routed V05
    [LM5116-05.kicad_pcb, LM5116-05.kicad_sch]
2023-02-01 Added Gerbers
    [LM5116-05-B_Cu.gbl, LM5116-05-B_Mask.gbs, LM5116-05-B_Paste.gbp, LM5116-05-B_Silkscreen.gbo, LM5116-05-Edge_Cuts.gm1, LM5116-05-F_Cu.gtl, LM5116-05-F_Mask.gts, LM5116-05-F_Paste.gtp]
2023-02-15 Fixed ho copper pour
    [LM5116-05.kicad_pcb]
2025-11-10 updating working tree
    [LM5116-05-B_Cu.gbl, LM5116-05-B_Mask.gbs, LM5116-05-B_Paste.gbp, LM5116-05-B_Silkscreen.gbo, LM5116-05-Edge_Cuts.gm1, LM5116-05-F_Cu.gtl, LM5116-05-F_Mask.gts, LM5116-05-F_Paste.gtp]
2025-11-10 added LM5013-5V, schematic capture
    [5013-5V.kicad_pcb, 5013-5V.kicad_sch, LM5116-05.kicad_pcb, LM5116-05.kicad_sch]
2025-11-11 added rev4 powerhat testing to buildnotes
    [LM5116-05.kicad_pcb, LM5116-05.kicad_sch]
2025-11-13 moved hat layout to new folder, focusing on LM5013
    [5013-5V_hat.kicad_pcb, 5013-5V_hat.kicad_sch, 5013-5v.kicad_pcb, 5013-5v.kicad_sch, LM5013-Q1DDA_TRANS.OLB, LM5013-Q1_TRANS.OPJ]
2025-11-13 added regulators, rough layout
    [5013-5v.kicad_pcb, 5013-5v.kicad_sch, 5013-5v_regulators.kicad_sch]
2025-11-17 5013 rough layout complete
    [5013-5v.kicad_pcb, 5013-5v.kicad_sch, 5013-5v_regulators.kicad_sch]
2025-11-17 routed pcbnew, gathering bom
    [5013-5v.kicad_pcb, 5013-5v.kicad_sch]
2025-11-18 added rev1BOM, fixed pours
    [5013-5v.kicad_pcb, 5013-5v.kicad_sch, 5013-5v_regulators.kicad_sch]
2025-11-24 plotted rev1 gerbers
    [5013-5v-B_Cu.gbl, 5013-5v-B_Mask.gbs, 5013-5v-B_Paste.gbp, 5013-5v-B_Silkscreen.gbo, 5013-5v-Edge_Cuts.gm1, 5013-5v-F_Cu.gtl, 5013-5v-F_Mask.gts, 5013-5v-F_Paste.gtp]
2025-12-16 updated buildnote with testing results'
    [5013-5v.kicad_pcb]
2025-12-30 Updated buildnote with current sense data
2026-01-19 new tests with 10W resistors
2026-02-10 began 5013-5v rev2 pcbnew
    [5013-5v.kicad_pcb]
